benjivou/Jumping-drone--Arduino/README.md

Polytech
# Jumping-drone--Arduino
Ce projet est réalisé dans le cadre de la formation de prépa intégrée Polytech'Nice Sophia

Un drone terrestre à deux roues, personnalisable visuellement avec des leds et capable de sauter. Le tout controlable avec un smartphone via bluetooth.

# Matériel

* Une carte Arduino 
* 3 batteries 9V 800mAh rechargeables
* Un module bluetooth HC-06
* Deux moteurs continues fortement reduits
* Une carte de controle moteurs
* Des resistances et des fils
* Un servo moteur 996r
* Deux ressorts
* Du bois, du plexiglass et de la quincaillerie. 

# Vidéo de démonstration :
IMAGE ALT TEXT HERE (https://www.youtube.com/watch?v=BWEitpaMLQ0)
