benjivou/Jumping-drone--Arduino/PrenomNOM.md

# Jour 1 (12/01/18):(Vouillon)
-Création du Github  
-Découverte des piéces du moteur  
-Recherche de la solution d'éclairage du drone   
-Création d'une maquette low cost pour les moteurs(https://github.com/benjivou/Jumping-drone--Arduino/blob/doc/P_20180112_105202.jpg)
