benjivou/Jumping-drone--Arduino/Doc/PrésentationF.pdf

# PROJET : JUMPING DRONE COMPTE-RENDU FINAL

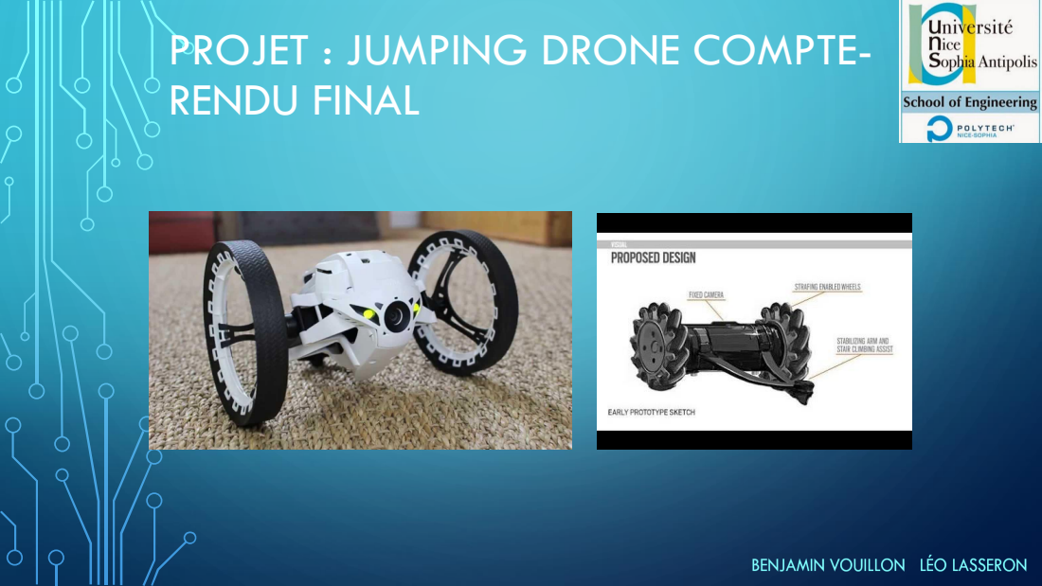
[picture p17: page 1]

## INTRODUCTION

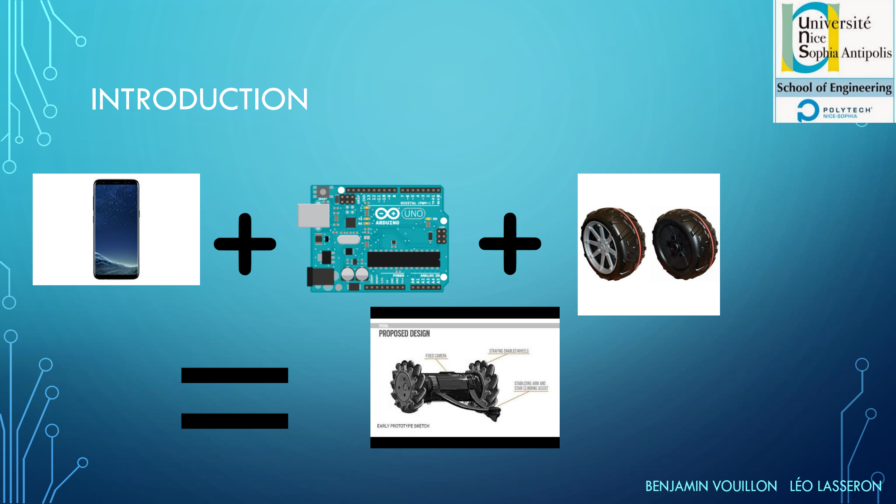
[picture p18: page 2]

## MOTIVATION

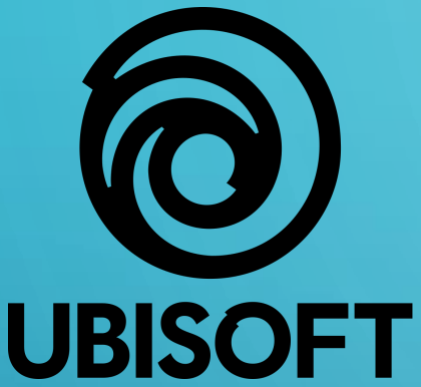
[picture p19: figure]
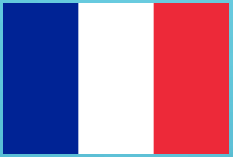
[picture p20: figure]
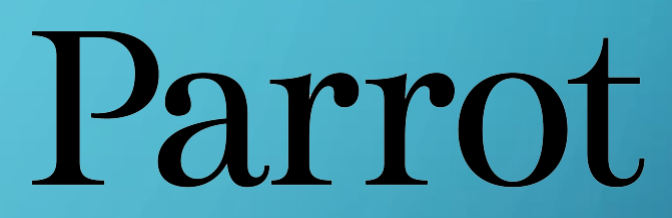
[picture p21: figure]
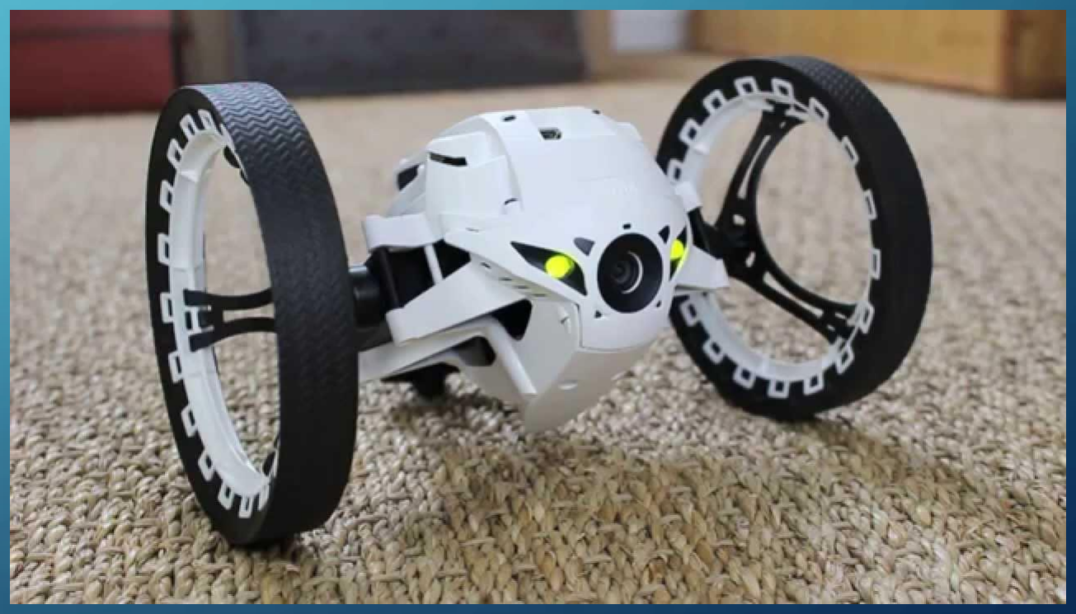
[picture p22: figure]
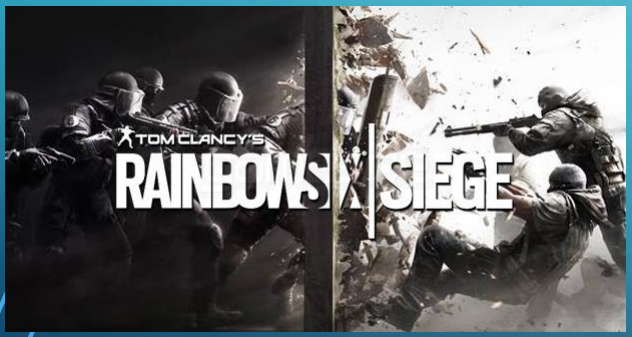
[picture p23: figure]

## SOMMAIRE

LE DRONE PARTIE PAR PARTIE

LES EXPÉRIENCES PERSONNELLES

LES AMÉLIORATIONS DU DRONE

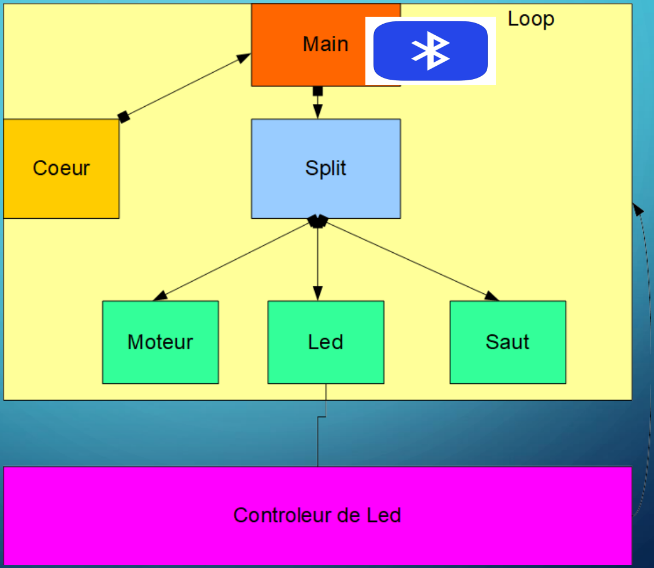
[picture p24: figure]

## LE CODE

## LE BLOC LED

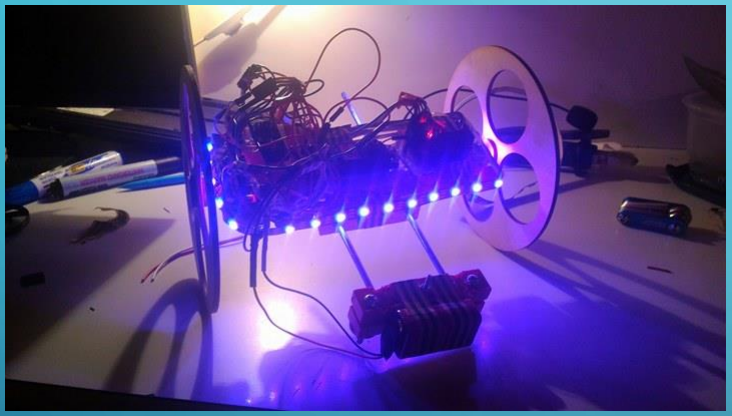
[picture p25: figure]
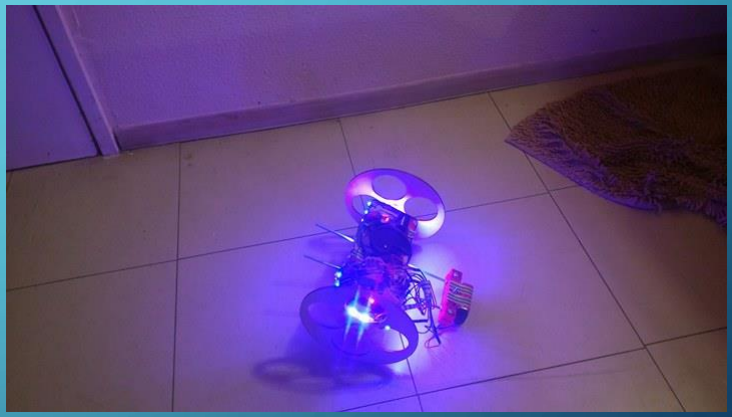
[picture p26: figure]

## LE BLOC MOTEUR

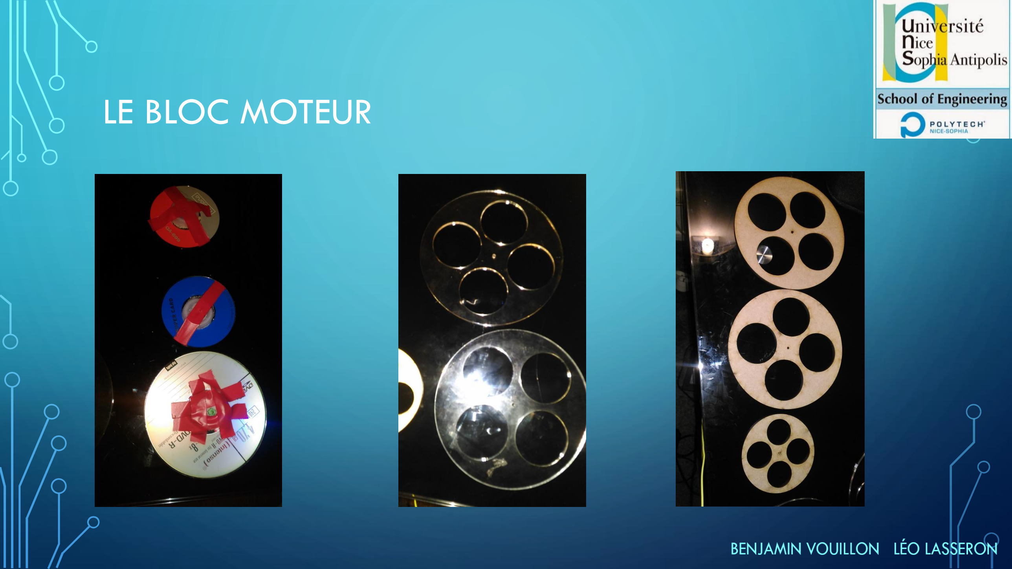
[picture p27: page 7]

## LE BLOC SAUT + CONNECTIQUES

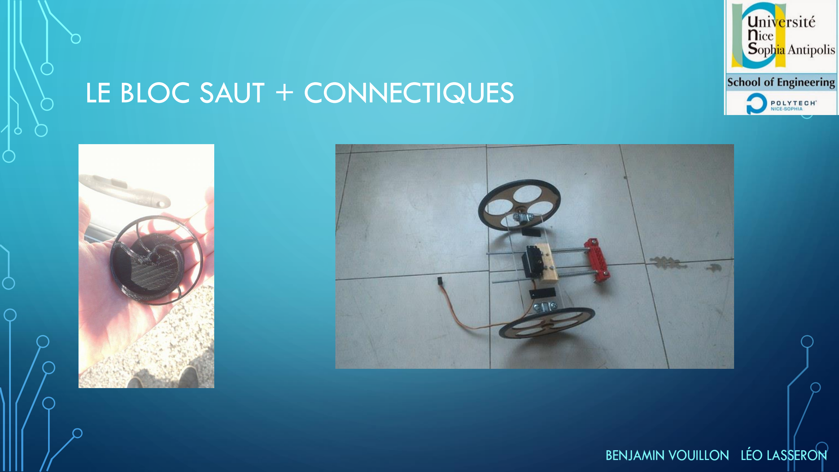
[picture p28: page 8]

## RÉPARTITION DU TRAVAIL

BENJAMIN
❖Homogénéisation du code

❖Moteurs

❖Maquettes

❖Requêtes BT et Traitement

LÉO
❖LED

❖Saut

❖Montage finale

❖Tests finaux

## AMÉLIORATIONS

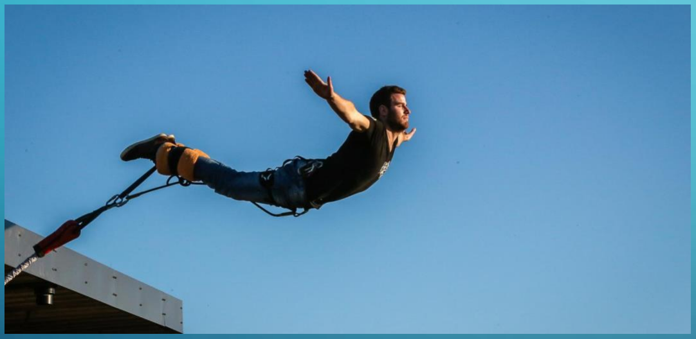
[picture p29: figure]
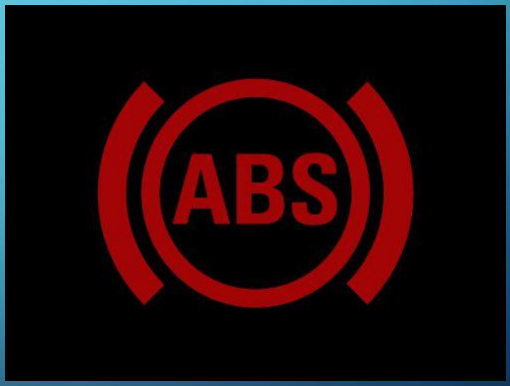
[picture p30: figure]
